Msadr471/Jammer_Project/Jammer/Project Outputs for Jammer/Jammer.jpg

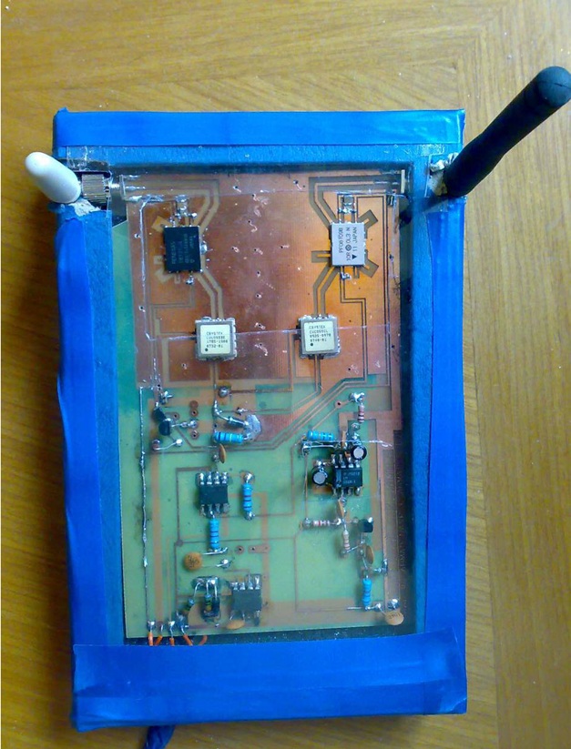
Jammer/Project Outputs for Jammer/Jammer.jpg
