Msadr471/Jammer_Project/Jammer/Project Outputs for Jammer/Change Order Report For Project.PDF

## Change Order Report For Project Jammer.PrjPcb And Jammer.PrjPcb

Action | Object | Change Document | Status

Add Components
Add | Antenna DCS1800 | To Jammer.PcbDoc
Add | Antenna GSM900 | To Jammer.PcbDoc
Add | C1 | To Jammer.PcbDoc
Add | C2 | To Jammer.PcbDoc
Add | C3 | To Jammer.PcbDoc
Add | C4 | To Jammer.PcbDoc
Add | C5 | To Jammer.PcbDoc
Add | C6 | To Jammer.PcbDoc
Add | C7 | To Jammer.PcbDoc
Add | C8 | To Jammer.PcbDoc
Add | C9 | To Jammer.PcbDoc
Add | C10 | To Jammer.PcbDoc
Add | C11 | To Jammer.PcbDoc
Add | C12 | To Jammer.PcbDoc
Add | C13 | To Jammer.PcbDoc
Add | C14 | To Jammer.PcbDoc
Add | C17 | To Jammer.PcbDoc
Add | C18 | To Jammer.PcbDoc
Add | C19 | To Jammer.PcbDoc
Add | C20 | To Jammer.PcbDoc
Add | C21 | To Jammer.PcbDoc
Add | C22 | To Jammer.PcbDoc
Add | C23 | To Jammer.PcbDoc
Add | C24 | To Jammer.PcbDoc
Add | C25 | To Jammer.PcbDoc
Add | C26 | To Jammer.PcbDoc
Add | C27 | To Jammer.PcbDoc
Add | C28 | To Jammer.PcbDoc
Add | C29 | To Jammer.PcbDoc
Add | C30 | To Jammer.PcbDoc
Add | C31 | To Jammer.PcbDoc
Add | C32 | To Jammer.PcbDoc
Add | C33 | To Jammer.PcbDoc
Add | C34 | To Jammer.PcbDoc
Add | D1 | To Jammer.PcbDoc
Add | D2 | To Jammer.PcbDoc
Add | D3 | To Jammer.PcbDoc
Add | D4 | To Jammer.PcbDoc
Add | DZ1 | To Jammer.PcbDoc
Add | F1 | To Jammer.PcbDoc
Add | H1 | To Jammer.PcbDoc
Add | H2 | To Jammer.PcbDoc
Add | H3 | To Jammer.PcbDoc
Add | H4 | To Jammer.PcbDoc
Add | H5 | To Jammer.PcbDoc
Add | Input AC | To Jammer.PcbDoc
Add | L1 | To Jammer.PcbDoc
Add | L2 | To Jammer.PcbDoc
Add | L3 | To Jammer.PcbDoc
Add | L4 | To Jammer.PcbDoc
Add | L5 | To Jammer.PcbDoc
Add | PA1 | To Jammer.PcbDoc
Add | PA2 | To Jammer.PcbDoc
Add | Q1 | To Jammer.PcbDoc
Add | R1 | To Jammer.PcbDoc
Add | R2 | To Jammer.PcbDoc
Add | R3 | To Jammer.PcbDoc
Add | R4 | To Jammer.PcbDoc
Add | R5 | To Jammer.PcbDoc
Add | R6 | To Jammer.PcbDoc
Add | R7 | To Jammer.PcbDoc
Add | R8 | To Jammer.PcbDoc
Add | R9 | To Jammer.PcbDoc
Add | R10 | To Jammer.PcbDoc
Add | R11 | To Jammer.PcbDoc
Add | R12 | To Jammer.PcbDoc
Add | R13 | To Jammer.PcbDoc
2 of 1 Page AM 11:03:57 -28/2016ربتكِا28- هعمج

Action | Object | Change Document | Status

Add Components
Add | R14 | To Jammer.PcbDoc
Add | R15 | To Jammer.PcbDoc
Add | Reg1 | To Jammer.PcbDoc
Add | Reg2 | To Jammer.PcbDoc
Add | Reg3 | To Jammer.PcbDoc
Add | Reg4 | To Jammer.PcbDoc
Add | Reg5 | To Jammer.PcbDoc
Add | U1 | To Jammer.PcbDoc
Add | U2 | To Jammer.PcbDoc
Add | U3 | To Jammer.PcbDoc
Add | VCO1 | To Jammer.PcbDoc
Add | VCO2 | To Jammer.PcbDoc

Add Nets
Add | GND | To Jammer.PcbDoc
Add | NetAntenna DCS1800_1 | To Jammer.PcbDoc
Add | NetAntenna GSM900_1 | To Jammer.PcbDoc
Add | NetC1_1 | To Jammer.PcbDoc
Add | NetC2_1 | To Jammer.PcbDoc
Add | NetC3_1 | To Jammer.PcbDoc
Add | NetC9_1 | To Jammer.PcbDoc
Add | NetC10_2 | To Jammer.PcbDoc
Add | NetC11_2 | To Jammer.PcbDoc
Add | NetC18_1 | To Jammer.PcbDoc
Add | NetC19_1 | To Jammer.PcbDoc
Add | NetC19_2 | To Jammer.PcbDoc
Add | NetC20_1 | To Jammer.PcbDoc
Add | NetC20_2 | To Jammer.PcbDoc
Add | NetC22_1 | To Jammer.PcbDoc
Add | NetC23_1 | To Jammer.PcbDoc
Add | NetC23_2 | To Jammer.PcbDoc
Add | NetC24_1 | To Jammer.PcbDoc
Add | NetC25_1 | To Jammer.PcbDoc
Add | NetC25_2 | To Jammer.PcbDoc
Add | NetC26_1 | To Jammer.PcbDoc
Add | NetC26_2 | To Jammer.PcbDoc
Add | NetC27_1 | To Jammer.PcbDoc
Add | NetC27_2 | To Jammer.PcbDoc
Add | NetC28_1 | To Jammer.PcbDoc
Add | NetC29_1 | To Jammer.PcbDoc
Add | NetC30_1 | To Jammer.PcbDoc
Add | NetD1_1 | To Jammer.PcbDoc
Add | NetD2_1 | To Jammer.PcbDoc
Add | NetD2_2 | To Jammer.PcbDoc
Add | NetD2_4 | To Jammer.PcbDoc
Add | NetD3_1 | To Jammer.PcbDoc
Add | NetL2_1 | To Jammer.PcbDoc
Add | NetL5_2 | To Jammer.PcbDoc
Add | NetPA1_9 | To Jammer.PcbDoc
Add | NetPA2_12 | To Jammer.PcbDoc
Add | NetR2_2 | To Jammer.PcbDoc
Add | NetR4_2 | To Jammer.PcbDoc
Add | NetR9_1 | To Jammer.PcbDoc

Add Component Classes
Add | Jammer | To Jammer.PcbDoc

Add Rooms
Add | Room Jammer | To Jammer.PcbDoc
| (Scope=InComponentClass('Jammer')) TopLayer

2 of 2 Page AM 11:03:57 -28/2016ربتكِا28- هعمج
