Msadr471/Jammer_Project/Jammer/Project Outputs for Jammer/Bill of Materials-Jammer.xlsx

Quantity | Comment | Description | Designator | Footprint | LibRef
1 | DCS1800 | Antenna DCS1800 | Antenna DCS1800 | BNC - Connector | BNC
1 | GSM900 | Antenna GSM900 | Antenna GSM900 | BNC - Connector | BNC
5 | 2200uF | Capacitor Electrolytic | C1, C2, C3, C10, C11 | cap 04 | Cap-Polar
4 | 330nF | Capacitor Ceramic | C4, C6, C13, C14 | Cap - 100nF - 2 | Cap-Bipolar
12 | 100nF | Capacitor Ceramic | C5, C7, C12, C19, C20, C21, C24, C25, C27, C28, C31, C34 | Cap - 100nF - 2 | Cap-Bipolar
4 | 100uF | Capacitor Electrolytic | C8, C9, C17, C18 | cap 04 | Cap-Polar
1 | 10nF | Capacitor Ceramic | C22 | Cap - 100nF - 2 | Cap-Bipolar
2 | 10uF | Capacitor Electrolytic | C23, C26 | cap 01 | Cap-Polar
2 | 1nF | Capacitor ceramic | C29, C33 | Cap - 100nF - 2 | Cap-Bipolar
2 | 470uF | Capacitor Electrolytic | C30, C32 | cap 03 | Cap-Polar
1 | LED | LED | D1 | GREEN LED 5mm | LED Full color
1 | Diode Bridge | Full Wave Diode Bridge | D2 | Diode Bridge | Diode Bridge
2 | 1N4007 | Rectifiers | D3, D4 | DO-41 | 1N4007
1 | 6.8V | Diode Zener | DZ1 | DO-41 | 1N4728A
1 | FUSE |  | F1 | FUSE_1 | FUSE
5 | Heatsink | Heatsink | H1, H2, H3, H4, H5 | Heatsink 2PIN | Heatsink
1 | Input AC | Header, 3-Pin | Input AC | HDR1X3 | Header 3
5 | 100uH | Magnetic-Core Inductor | L1, L2, L3, L4, L5 | AXIAL-0.9 | Inductor Iron
2 | PF08109B | Power Amplifier | PA1, PA2 | RF-O-12 | Power Amplifier
1 | 2N2222A | NPN Transistor_Created by DESIGNER (M.Hariri) | Q1 | TO52 | 2N2222A
2 | 1K | Resistor, Resistor 1/4W | R1, R12 | Res-(1/4) | Resistor
1 | 100R | Resistor | R2 | Res-(1/4) | Resistor
1 | 180R | Resistor | R3 | Res-(1/4) | Resistor
1 | 160R | Resistor | R4 | Res-(1/4) | Resistor
1 | 148R | Resistor | R5 | Res-(1/4) | Resistor
2 | 700R | Resistor 1/4W | R6, R7 | Res-(1/4) | Resistor
1 | 82K | Resistor 1/4W | R8 | Res-(1/4) | Resistor
4 | 2K | Resistor 1/4W | R9, R11, R14, R15 | Res-(1/4) | Resistor
1 | 10R | Resistor 1/4W | R10 | Res-(1/4) | Resistor
1 | 33K | Resistor 1/4W | R13 | Res-(1/4) | Resistor
1 | L7812 | TO-220 | Reg1 | TO-220 | Voltage Regulator
1 | L7805 | TO-220 | Reg2 | TO-220 | Voltage Regulator
2 | LM317 | TO-220 | Reg3, Reg4 | TO-220 | Voltage Regulator
1 | L7912 | TO-220 | Reg5 | TO-220 | Voltage Regulator
1 | NE555 | GENERAL PURPOSE SINGLE BIPOLAR TIMERS | U1 | DIP8 | NE555
1 | LM741-UA741 | (OP-AMP) | U2 | DIP8 | LM741-UA741
1 | LM386 | Audio Amplifier | U3 | DIP8 | LM386
1 | CVCO55CL | SMD | VCO1 | CVCO55CL | CVCO055CL
1 | CVCO55BE | SMD | VCO2 | CVCO55BE | CVCO055BE
