Msadr471/Jammer_Project/Jammer/Project Outputs for Jammer/Change Order Report For Project 2.PDF

## Change Order Report For Project P-Jammer.PrjPcb And P-Jammer.PrjPcb

Action | Object | Change Document | Status

Change Component Footprints
Modify | AXIAL-0.9 -> Res-(1/1) [L1] | In | SCH-Jamme.SchDoc
Modify | AXIAL-0.9 -> Res-(1/1) [L2] | In | SCH-Jamme.SchDoc
Modify | AXIAL-0.9 -> Res-(1/1) [L3] | In | SCH-Jamme.SchDoc
Modify | AXIAL-0.9 -> Res-(1/1) [L4] | In | SCH-Jamme.SchDoc
Modify | AXIAL-0.9 -> Res-(1/1) [L5] | In | SCH-Jamme.SchDoc

1 of 1 Page PM 9:11:28 -08/2016ربماون8- هبنش هس
