Msadr471/Jammer_Project/PDFs/IF-Section.pdf

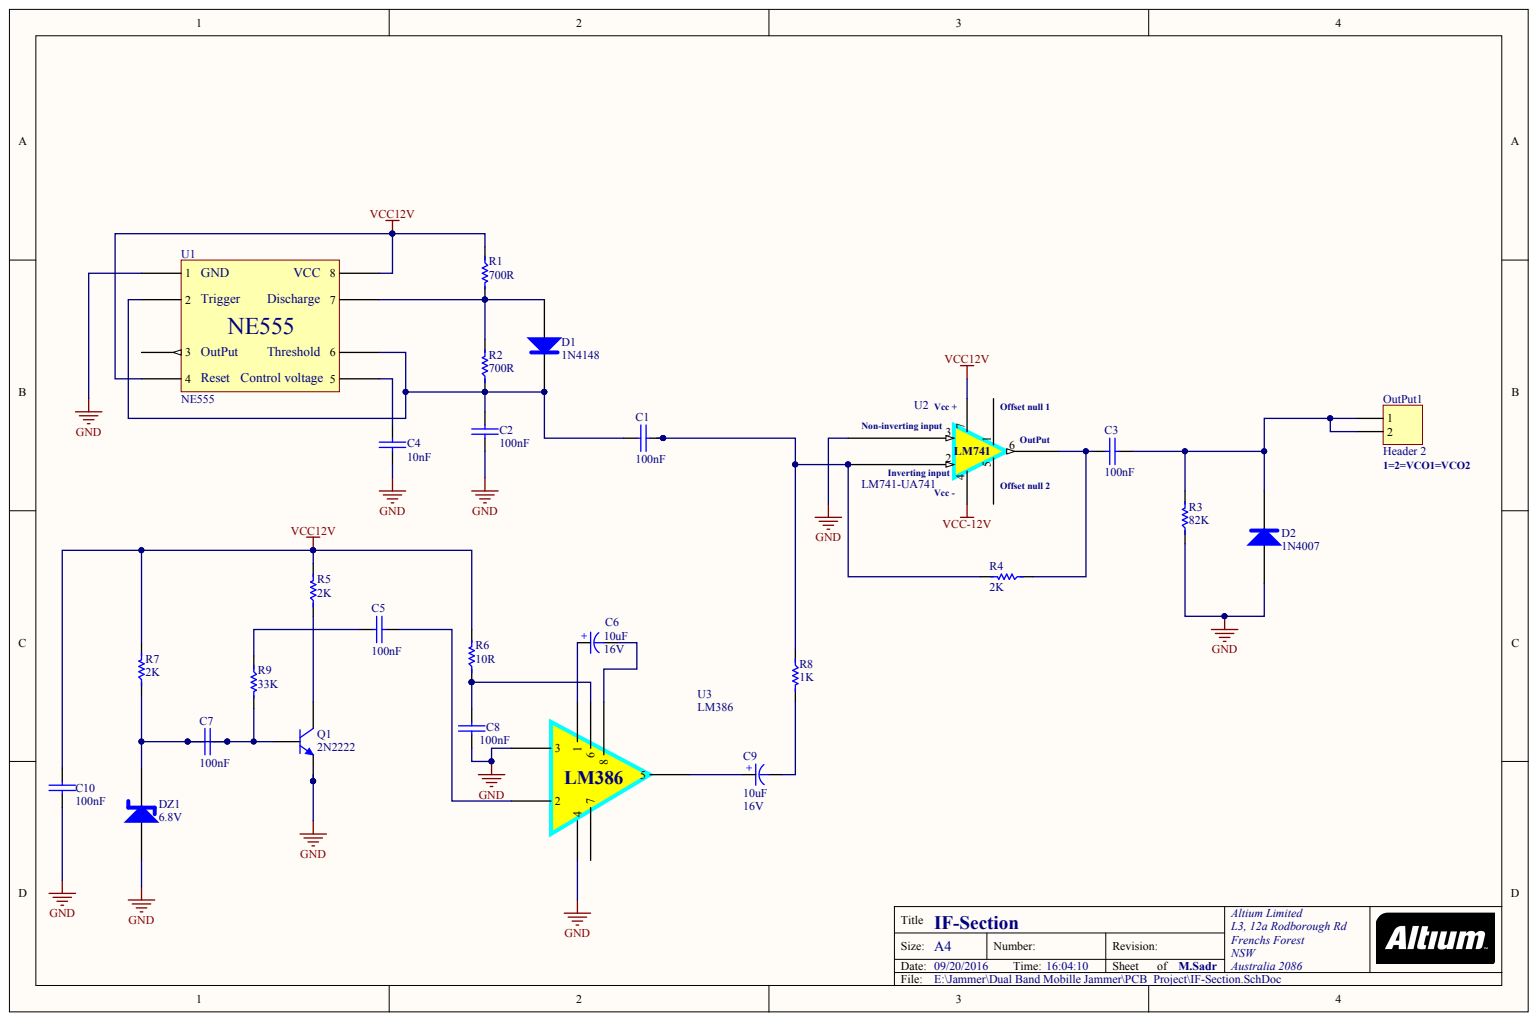
[picture p53: page 1]

Title IF-Section | Altium Limited L3, 12a Rodborough Rd Frenchs Forest NSW Australia 2086

Size: A4 | Number: | Revision:
Date: 09/20/2016 Time: 16:04:10 | | Sheet of M.Sadr

E:\Jammer\Dual Band Mobille Jammer\PCB_Project\IF-Section.SchDoc
