Msadr471/Jammer_Project/PDFs/POWER SUPPLY.pdf

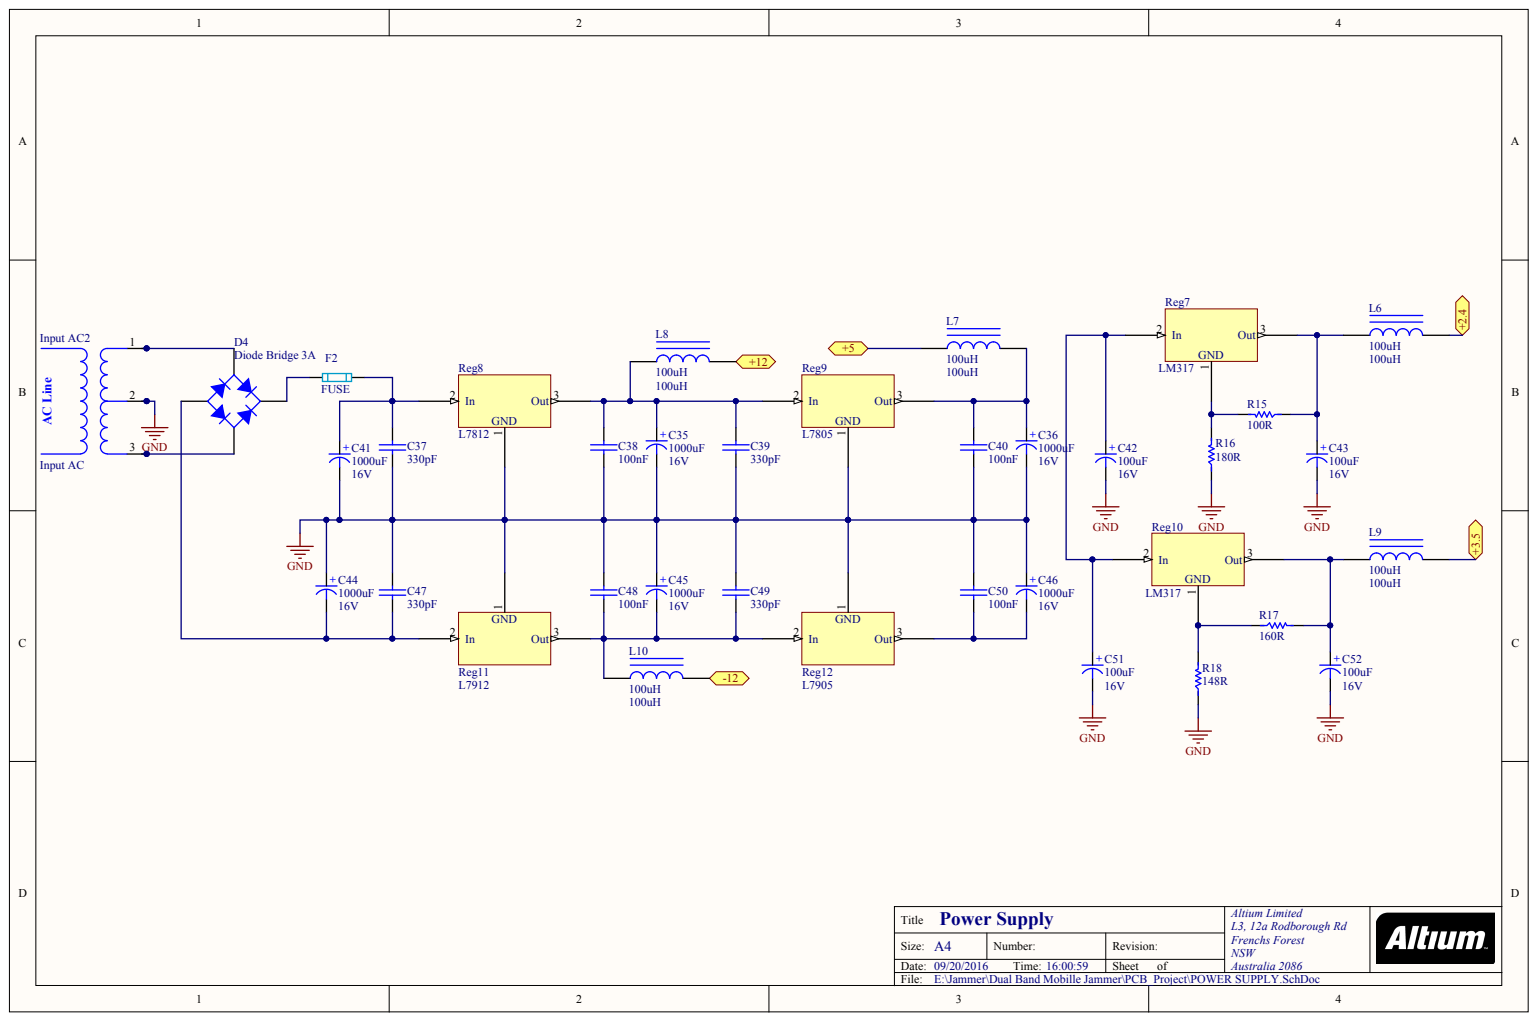
[picture p54: page 1]

Power Supply Title | Altium Limited L3, 12a Rodborough Rd Frenchs Forest NSW Australia 2086

Size: A4 | Number: | Revision:
Date: 09/20/2016 Time: 16:00:59 | | Sheet of

E:\Jammer\Dual Band Mobille Jammer\PCB_Project\POWER SUPPLY.SchDoc
