Msadr471/Jammer_Project/PDFs/RF-Section.pdf

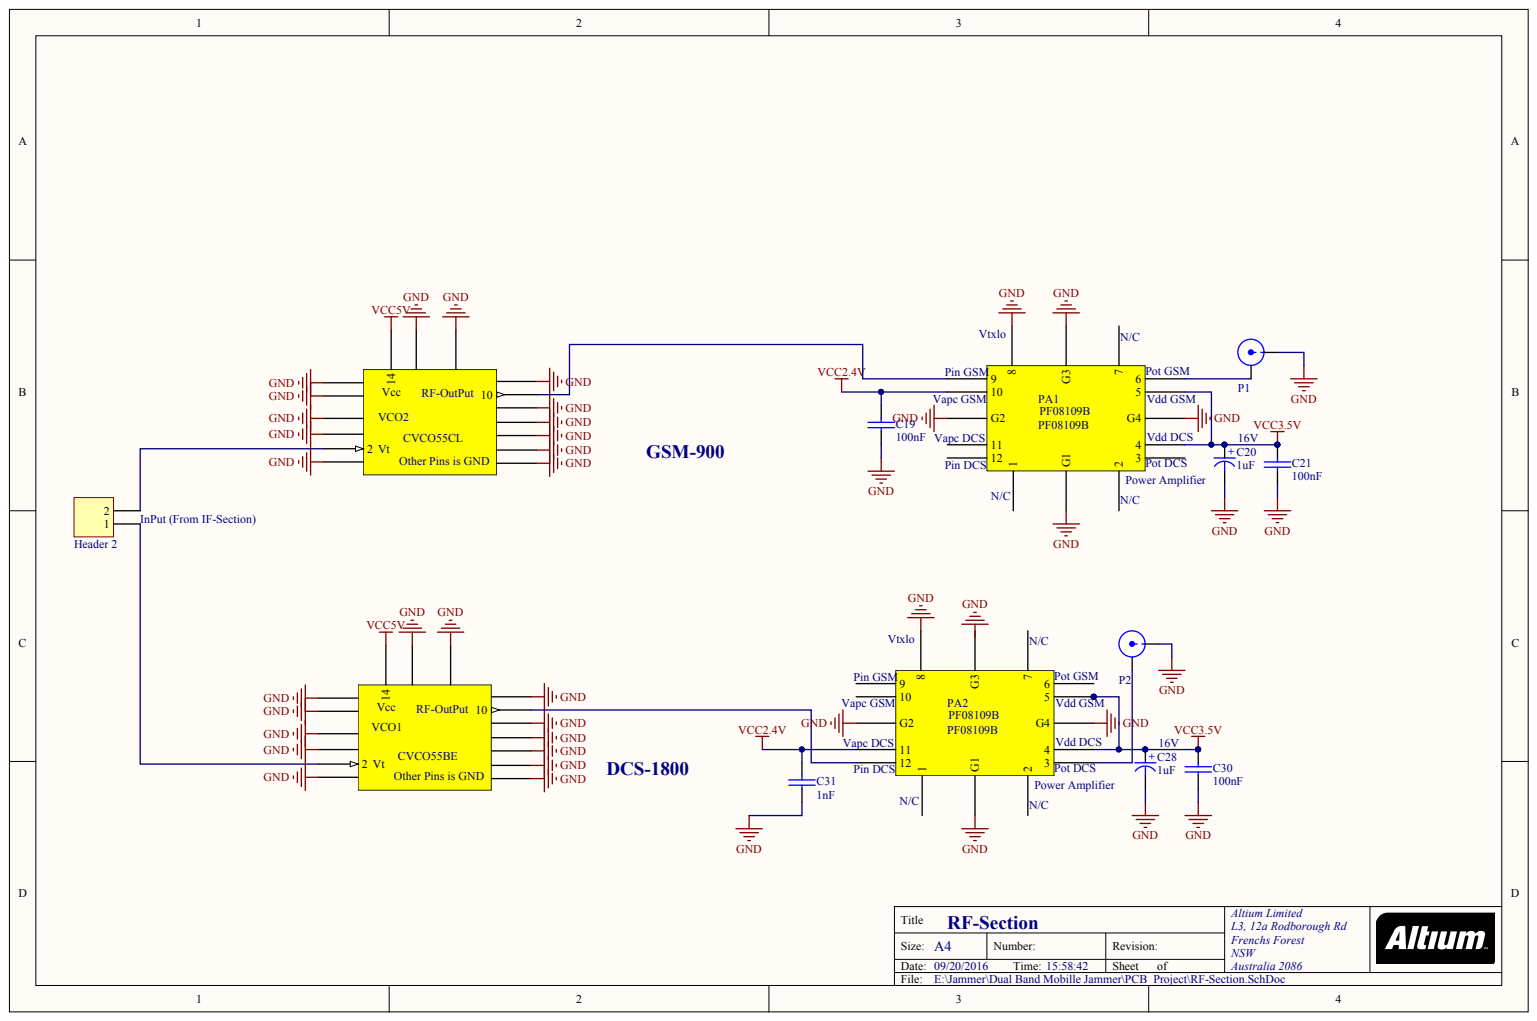
[picture p55: page 1]

CVCO55CL
Vt Other Pins is GND

Vdd GSM

Vdd DCS

Title RF-Section | Altium Limited L3, 12a Rodborough Rd Frenchs Forest NSW Australia 2086

Size: A4 | Number: | Revision:
Date: 09/20/2016 Time: 15:58:42 | | Sheet of

E:\Jammer\Dual Band Mobille Jammer\PCB_Project\RF-Section.SchDoc
