Msadr471/Jammer_Project/Jammer/Project Outputs for Jammer/P-Jammer 2.pdf

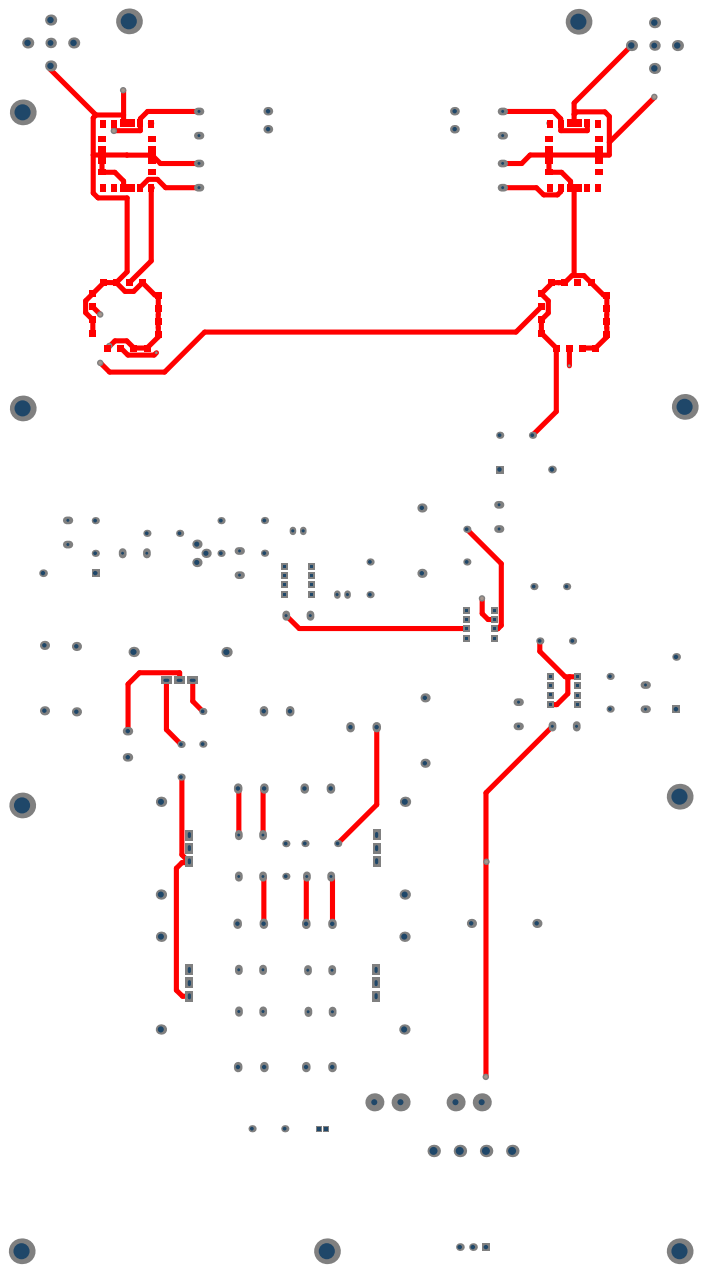
[picture p56: page 1]
