Msadr471/Jammer_Project/Jammer/Project Outputs for Jammer/P-Jammer.pdf

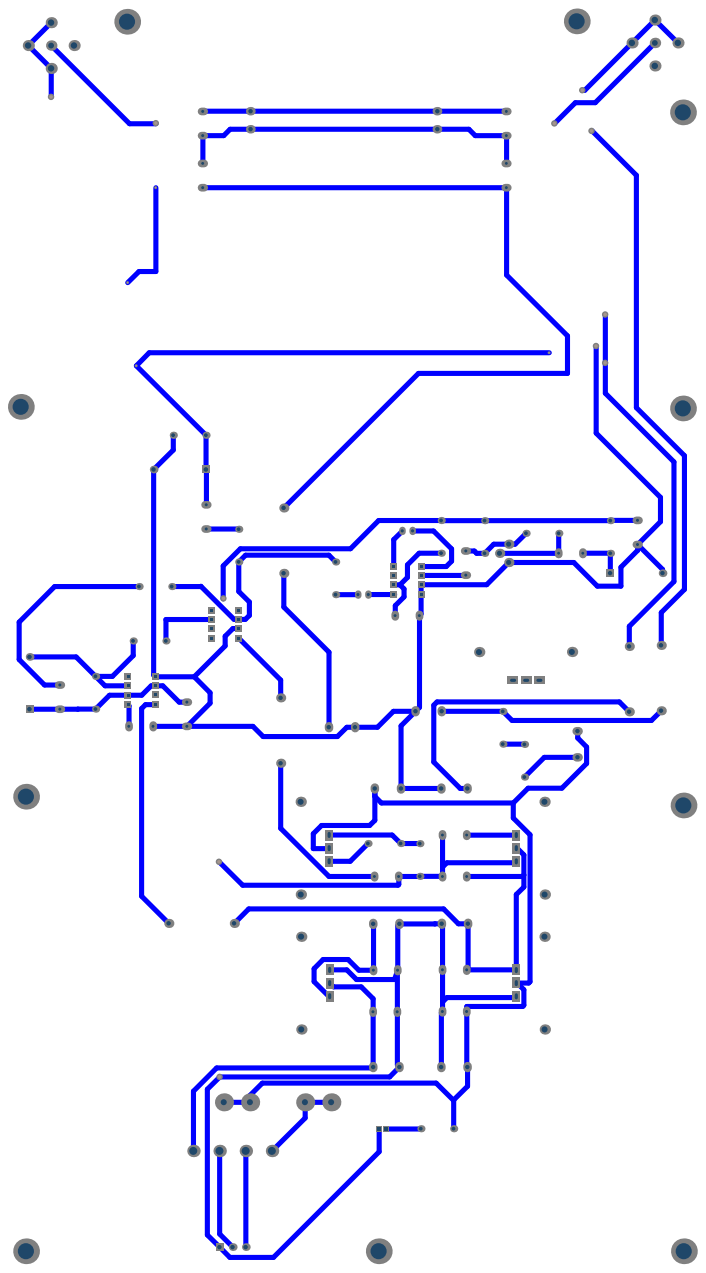
[picture p57: page 1]
