Msadr471/Jammer_Project/(list of files, drawings)

Other design files:
Jammer/P-Jammer.PrjPcb
Jammer/PCB-Jammer.PcbDoc
Jammer/SCH-Jamme.SchDoc
Jammer/Simulation whit Proteus/IF-Section.pdsprj
Jammer/Simulation whit Proteus/NOISE GENERATION.pdsprj
Jammer/Simulation whit Proteus/Power Supply For Jammer.pdsprj
Jammer/Simulation whit Proteus/Triangular Wave Generator.ms13
Jammer/Simulation whit Proteus/Triangular Wave Generator.pdsprj
